gaoyichuan/Spectrometer_Tang/mechinal/slit-magnet-holder.sldprt

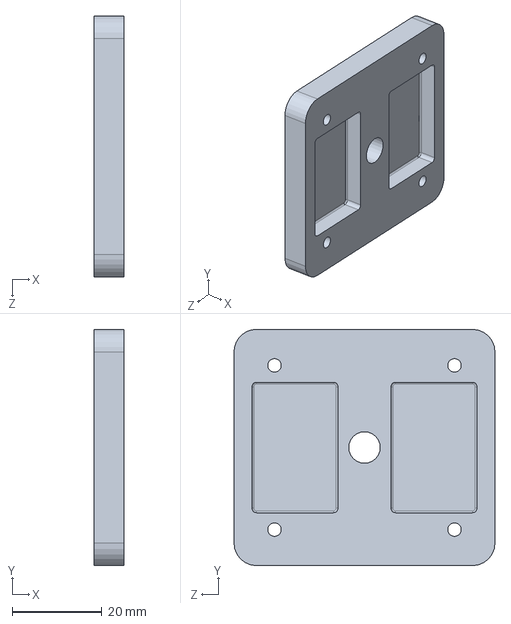
[picture p1: CAD file, 2019-06-28]
mechinal/slit-magnet-holder.sldprt
6.70 x 52.5 x 58.0 mm
