gaoyichuan/Spectrometer_Tang/mechinal/spectrometer-box.sldprt

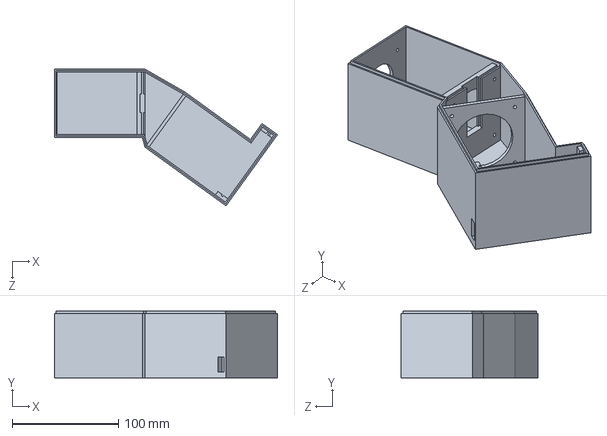
[picture p2: CAD file, 2019-06-28]
mechinal/spectrometer-box.sldprt
209.5 x 62.5 x 128.4 mm
