gaoyichuan/Spectrometer_Tang/mechinal/grating-holder.sldprt

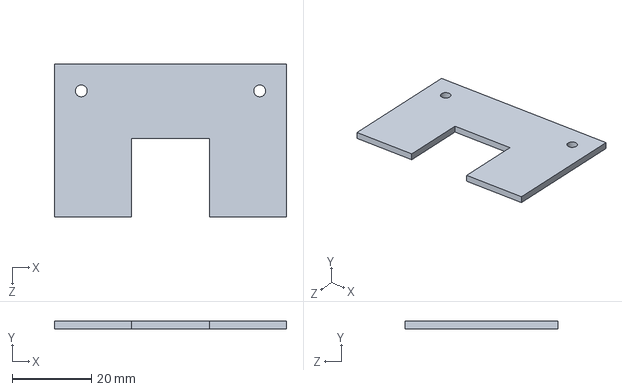
[picture p3: CAD file, 2019-06-28]
mechinal/grating-holder.sldprt
58.5 x 1.90 x 38.5 mm
