gaoyichuan/Spectrometer_Tang/mechinal/spectrometer-top.sldprt

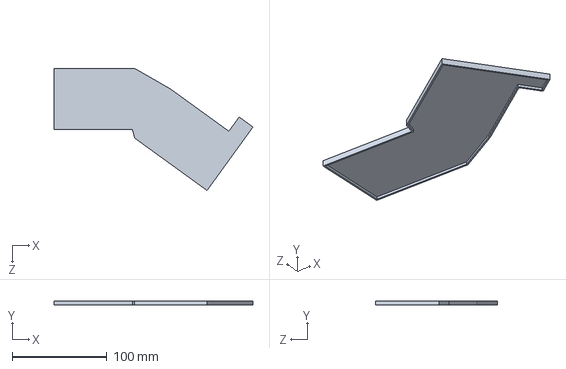
[picture p4: CAD file, 2019-06-28]
mechinal/spectrometer-top.sldprt
209.5 x 4.50 x 128.4 mm
