gaoyichuan/Spectrometer_Tang/(list of files, cad)

Other CAD files:
mechinal/slit-magnet-holder.stl
mechinal/spectrometer-box.stl
mechinal/spectrometer-top.stl
