gaoyichuan/Spectrometer_Tang/hardware/Spectrometer_Tang.pdf

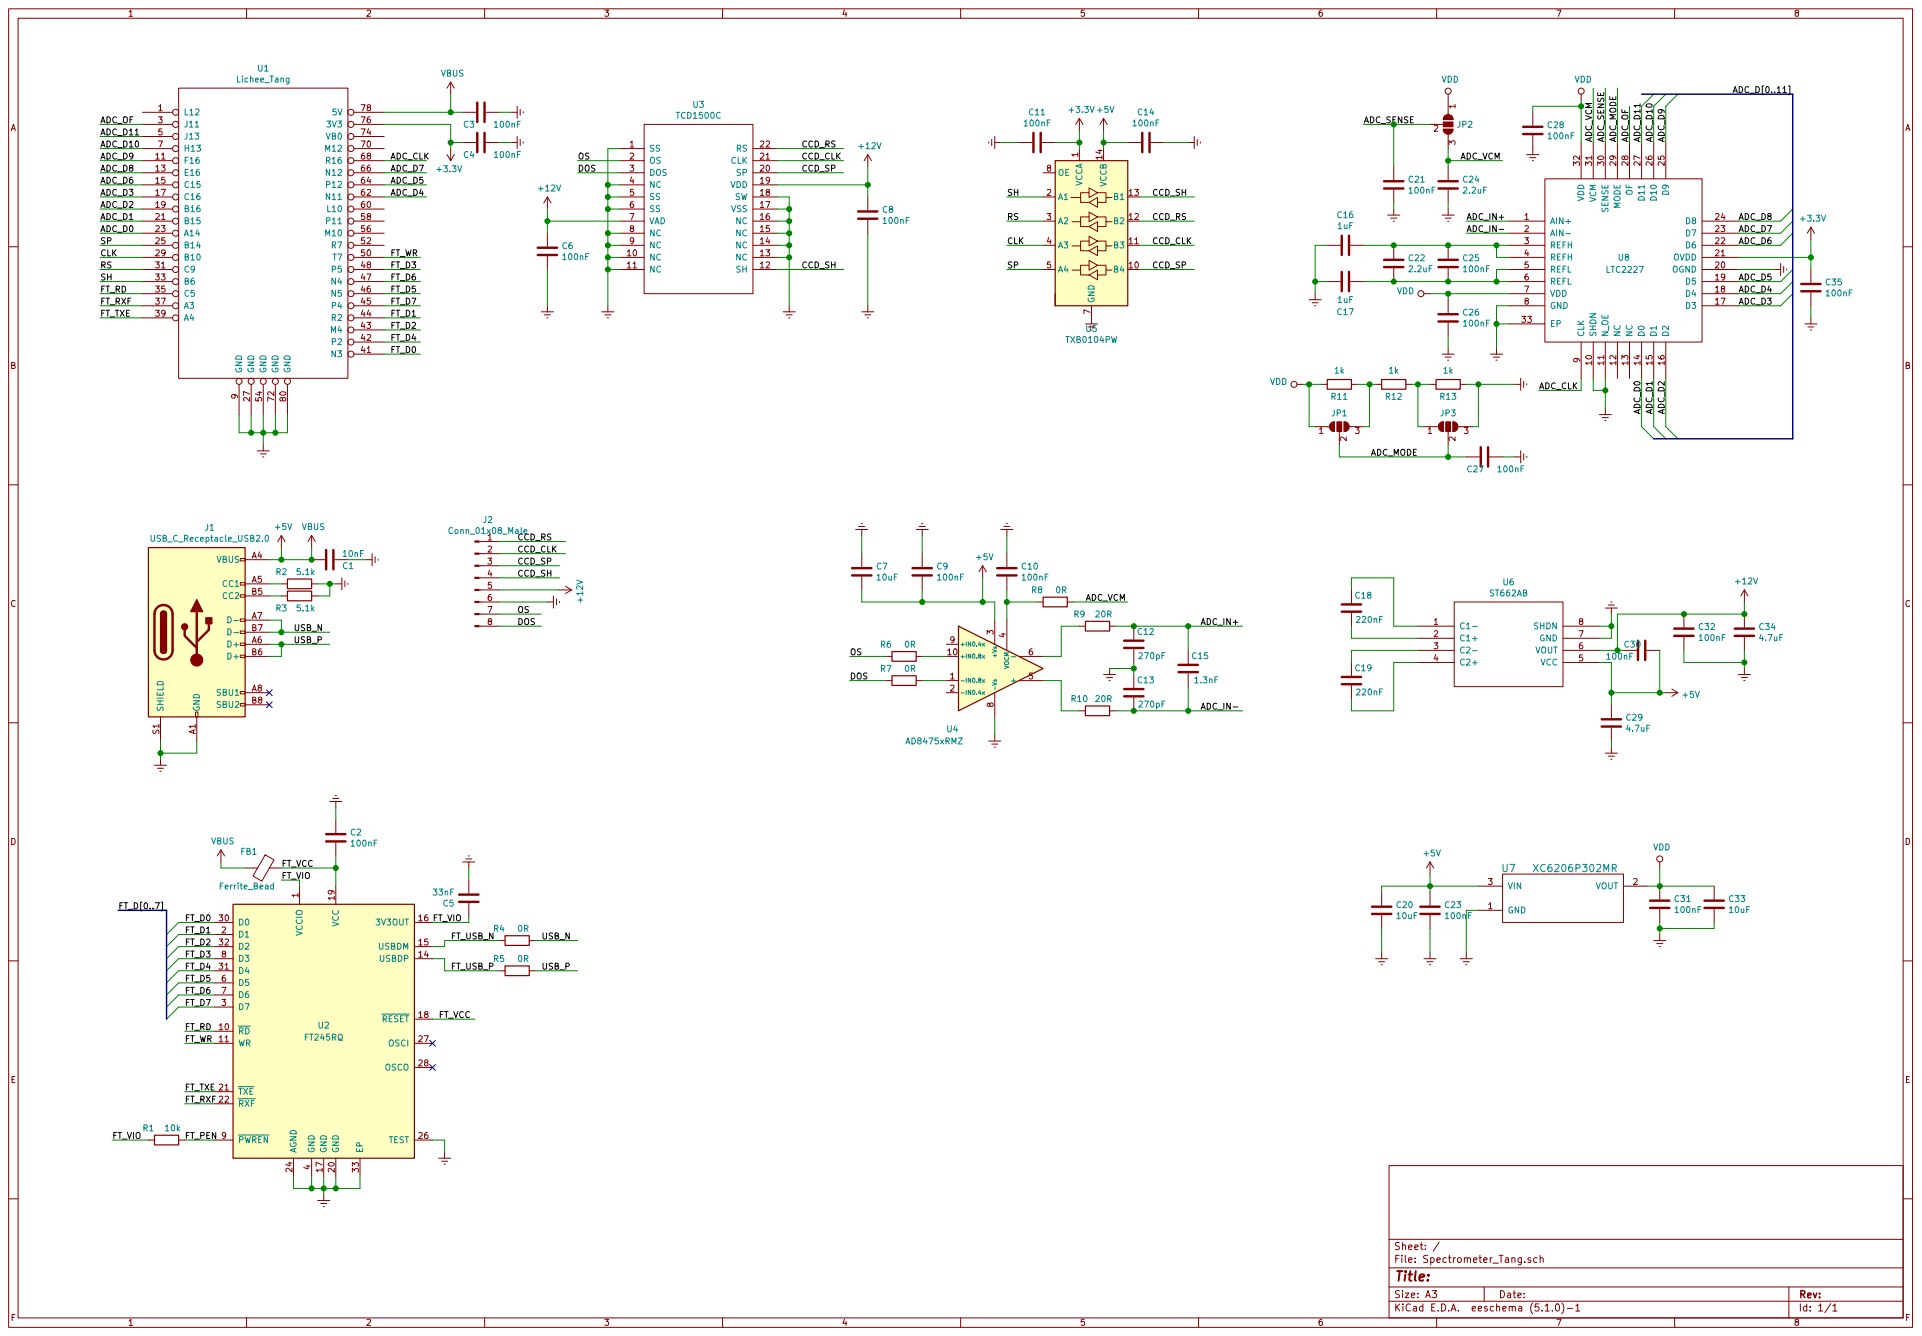
[picture p5: page 1]

1 RD 10 WR 11 USBDP 14 USBDM 15
