gaoyichuan/Spectrometer_Tang/hardware/Spectrometer_Tang.kicad_pcb

## KiCad design hardware/Spectrometer_Tang.kicad_pcb (2019-11-11)

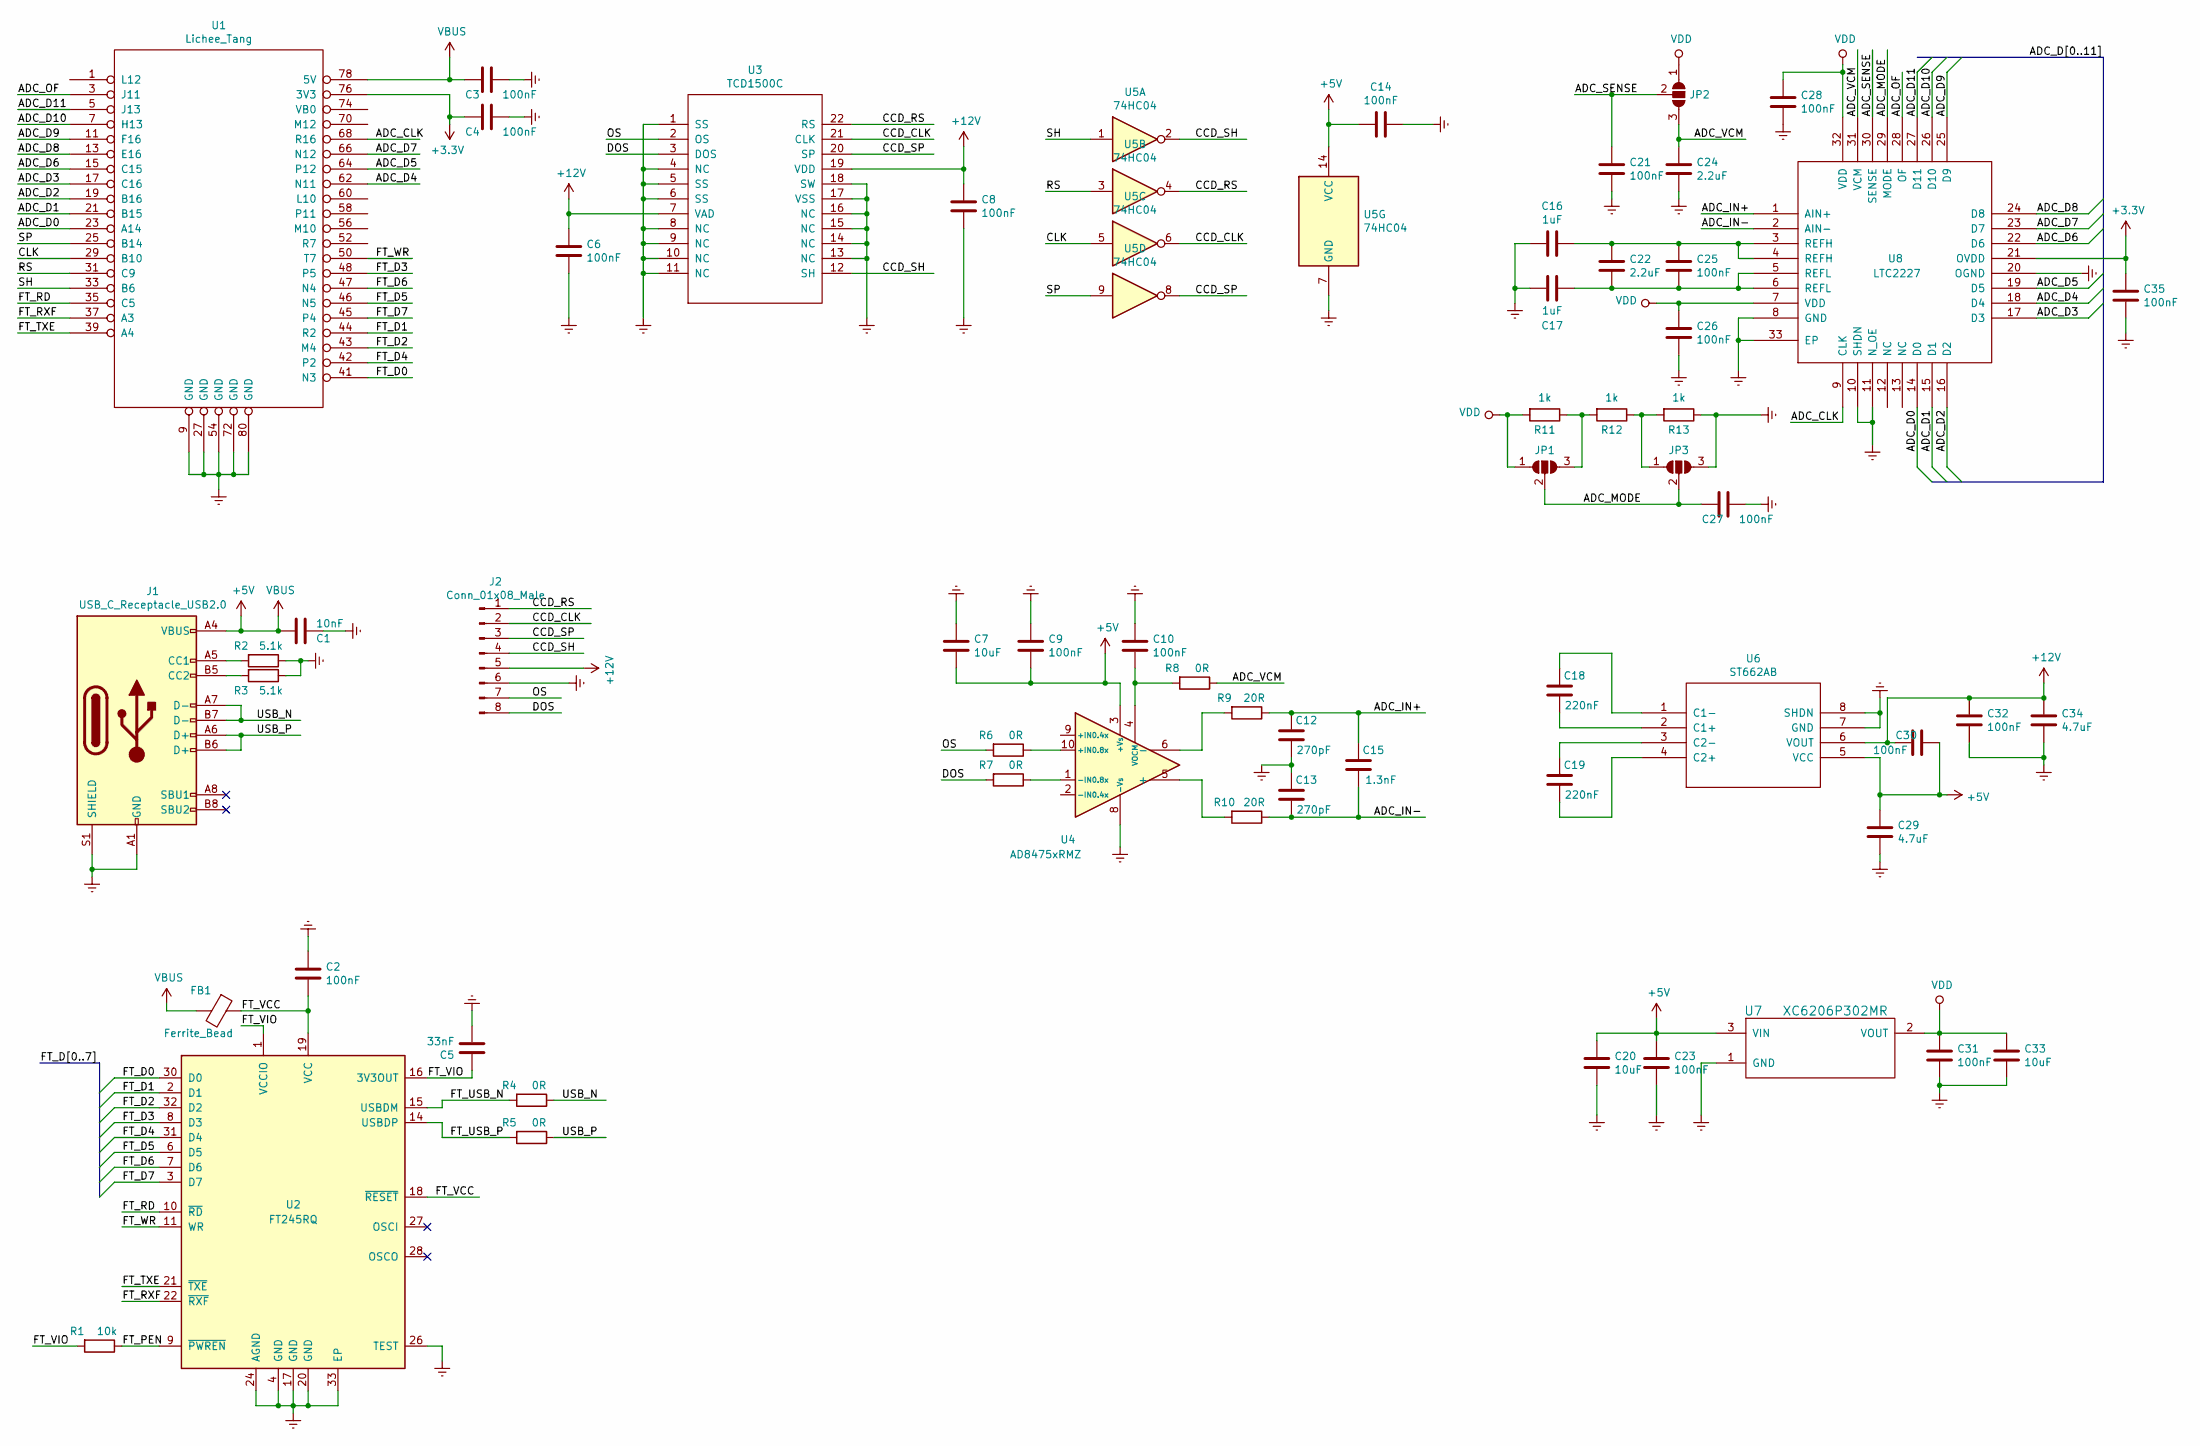
[picture p6: schematic Spectrometer_Tang.sch]

Parts:
C1: 10nF; C_0603_1608Metric_Pad1.05x0.95mm_HandSolder
C2, C3, C4, C6, C8, C9, C10, C14, C21, C23, C25, C26, C27, C28, C30, C31, C32, C35: 100nF; C_0603_1608Metric_Pad1.05x0.95mm_HandSolder
C5: 33nF; C_0603_1608Metric_Pad1.05x0.95mm_HandSolder
C7, C20, C33: 10uF; C_0603_1608Metric_Pad1.05x0.95mm_HandSolder
C12, C13: 270pF; C_0603_1608Metric_Pad1.05x0.95mm_HandSolder
C15: 1.3nF; C_0603_1608Metric_Pad1.05x0.95mm_HandSolder
C16, C17: 1uF; C_0603_1608Metric_Pad1.05x0.95mm_HandSolder
C18, C19: 220nF; C_0603_1608Metric_Pad1.05x0.95mm_HandSolder
C22, C24: 2.2uF; C_0603_1608Metric_Pad1.05x0.95mm_HandSolder
C29, C34: 4.7uF; C_0805_2012Metric
FB1: Ferrite_Bead; R_0603_1608Metric
J1: USB_C_Receptacle_USB2.0; USB_C_Receptacle_HRO_TYPE-C-31-M-12
J2: Conn_01x08_Male; PinHeader_1x08_P2.54mm_Vertical
JP1, JP2, JP3: SolderJumper_3_Open; SolderJumper-3_P1.3mm_Open_RoundedPad1.0x1.5mm
R1: 10k; R_0603_1608Metric_Pad1.05x0.95mm_HandSolder
R2, R3: 5.1k; R_0603_1608Metric_Pad1.05x0.95mm_HandSolder
R4, R5, R6, R7, R8: 0R; R_0603_1608Metric_Pad1.05x0.95mm_HandSolder
R9, R10: 20R; R_0603_1608Metric_Pad1.05x0.95mm_HandSolder
R11, R12, R13: 1k; R_0603_1608Metric_Pad1.05x0.95mm_HandSolder
U1: Lichee_Tang; Lichee-Tang-Module
U2: FT245RQ; QFN-32-1EP_5x5mm_P0.5mm_EP3.45x3.45mm_ThermalVias
U3: TCD1500C
U4: AD8475xRMZ; MSOP-10_3x3mm_P0.5mm
U5: 74HC04
U6: ST662AB; SO-8_3.9x4.9mm_P1.27mm
U7: XC6206P302MR; SOT-23
U8: LTC2227; QFN-32-1EP_5x5mm_P0.5mm_EP3.45x3.45mm_ThermalVias

Connections:
+3V3: C4.2, C35.1, U1.76 (3V3), U8.21 (OVDD)
+5V: C1.2, C3.2, C7.2, C9.2, C14.2, C20.1, C23.1, C29.1, C30.1, FB1.2, J1.A4 (VBUS), J1.A9 (VBUS), J1.B4 (VBUS), J1.B9 (VBUS), U1.78 (5V), U4.3 (+Vs), U5.14 (VCC), U6.5 (VCC), U7.3 (VIN)
+12V: C6.1, C8.1, C30.2, C32.1, C34.1, J2.5, U3.7 (VAD), U3.19 (VDD), U6.6 (VOUT)
/ADC_CLK: U1.68 (R16), U8.9 (CLK)
/ADC_D0: U1.23 (A14), U8.14 (D0)
/ADC_D1: U1.21 (B15), U8.15 (D1)
/ADC_D2: U1.19 (B16), U8.16 (D2)
/ADC_D3: U1.17 (C16), U8.17 (D3)
/ADC_D4: U1.62 (N11), U8.18 (D4)
/ADC_D5: U1.64 (P12), U8.19 (D5)
/ADC_D6: U1.15 (C15), U8.22 (D6)
/ADC_D7: U1.66 (N12), U8.23 (D7)
/ADC_D8: U1.13 (E16), U8.24 (D8)
/ADC_D9: U1.11 (F16), U8.25 (D9)
/ADC_D10: U1.7 (H13), U8.26 (D10)
/ADC_D11: U1.5 (J13), U8.27 (D11)
/ADC_IN+: C12.2, C15.2, R9.1, U8.1 (AIN+)
/ADC_IN-: C13.1, C15.1, R10.1, U8.2 (AIN-)
/ADC_MODE: C27.2, JP1.2 (C), JP3.2 (C), U8.29 (MODE)
/ADC_OF: U1.3 (J11), U8.28 (OF)
/ADC_SENSE: C21.1, JP2.2 (C), U8.30 (SENSE)
/ADC_VCM: C24.1, JP2.3 (B), R8.1, U8.31 (VCM)
/CCD_CLK: J2.2, U3.21 (CLK), U5.6
/CCD_RS: J2.1, U3.22 (RS), U5.4
/CCD_SH: J2.4, U3.12 (SH), U5.2
/CCD_SP: J2.3, U3.20 (SP), U5.8
/CLK: U1.29 (B10), U5.5
/DOS: J2.8, R7.2, U3.3 (DOS)
/FT_D0: U1.41 (N3), U2.30 (D0)
/FT_D1: U1.44 (R2), U2.2 (D1)
/FT_D2: U1.43 (M4), U2.32 (D2)
/FT_D3: U1.48 (P5), U2.8 (D3)
/FT_D4: U1.42 (P2), U2.31 (D4)
/FT_D5: U1.46 (N5), U2.6 (D5)
/FT_D6: U1.47 (N4), U2.7 (D6)
/FT_D7: U1.45 (P4), U2.3 (D7)
/FT_PEN: R1.1, U2.9 (~PWREN)
/FT_RD: U1.35 (C5), U2.10 (~RD)
/FT_RXF: U1.37 (A3), U2.22 (~RXF)
/FT_TXE: U1.39 (A4), U2.21 (~TXE)
/FT_USB_N: R4.2, U2.15 (USBDM)
/FT_USB_P: R5.2, U2.14 (USBDP)
/FT_VCC: C2.2, FB1.1, U2.18 (~RESET), U2.19 (VCC)
/FT_VIO: C5.1, R1.2, U2.1 (VCCIO), U2.16 (3V3OUT)
/FT_WR: U1.50 (T7), U2.11 (WR)
/OS: J2.7, R6.2, U3.2 (OS)
/RS: U1.31 (C9), U5.3
/SH: U1.33 (B6), U5.1
/SP: U1.25 (B14), U5.9
/USB_N: J1.A7 (D-), J1.B7 (D-), R4.1
/USB_P: J1.A6 (D+), J1.B6 (D+), R5.1
Earth: C1.1, C2.1, C3.1, C4.1, C5.2, C6.2, C7.1, C8.2, C9.1, C10.1, C12.1, C13.2, C14.1, C16.2, C17.2, C20.2, C21.2, C23.2, C24.2, C26.2, C27.1, C28.2, C29.2, C31.2, C32.2, C33.2, C34.2, C35.2, J1.A1 (GND), J1.A12 (GND), J1.B1 (GND), J1.B12 (GND), J1.S1 (SHIELD), J2.6, JP3.3 (B), R2.1, R3.1, R13.1, U1.9 (GND), U1.27 (GND), U1.54 (GND), U1.72 (GND), U1.80 (GND), U2.4 (GND), U2.17 (GND), U2.20 (GND), U2.24 (AGND), U2.26 (TEST), U2.33 (EP), U3.1 (SS), U3.4 (NC), U3.5 (SS), U3.6 (SS), U3.8 (NC), U3.9 (NC), U3.10 (NC), U3.11 (NC), U3.13 (NC), U3.14 (NC), U3.15 (NC), U3.16 (NC), U3.17 (VSS), U3.18 (SW), U4.8 (-Vs), U5.7 (GND), U6.7 (GND), U6.8 (SHDN), U7.1 (GND), U8.8 (GND), U8.10 (SHDN), U8.11 (N_OE), U8.20 (OGND), U8.33 (EP)
unnamed: C10.2, R8.2, U4.4 (VOCM)
unnamed: C16.1, C22.1, C25.1, U8.3 (REFH), U8.4 (REFH)
unnamed: C17.1, C22.2, C25.2, U8.5 (REFL), U8.6 (REFL)
unnamed: C18.1, U6.2 (C1+)
unnamed: C18.2, U6.1 (C1-)
unnamed: C19.1, U6.4 (C2+)
unnamed: C19.2, U6.3 (C2-)
unnamed: J1.A5 (CC1), R2.2
unnamed: J1.B5 (CC2), R3.2
unnamed: JP1.3 (B), R11.1, R12.2
unnamed: JP3.1 (A), R12.1, R13.2
unnamed: R6.1, U4.10 (+IN0.8x)
unnamed: R7.1, U4.1 (-IN0.8x)
unnamed: R9.2, U4.6 (-)
unnamed: R10.2, U4.5 (+)
VDD: C26.1, C28.1, C31.1, C33.1, JP1.1 (A), JP2.1 (A), R11.2, U7.2 (VOUT), U8.7 (VDD), U8.32 (VDD)

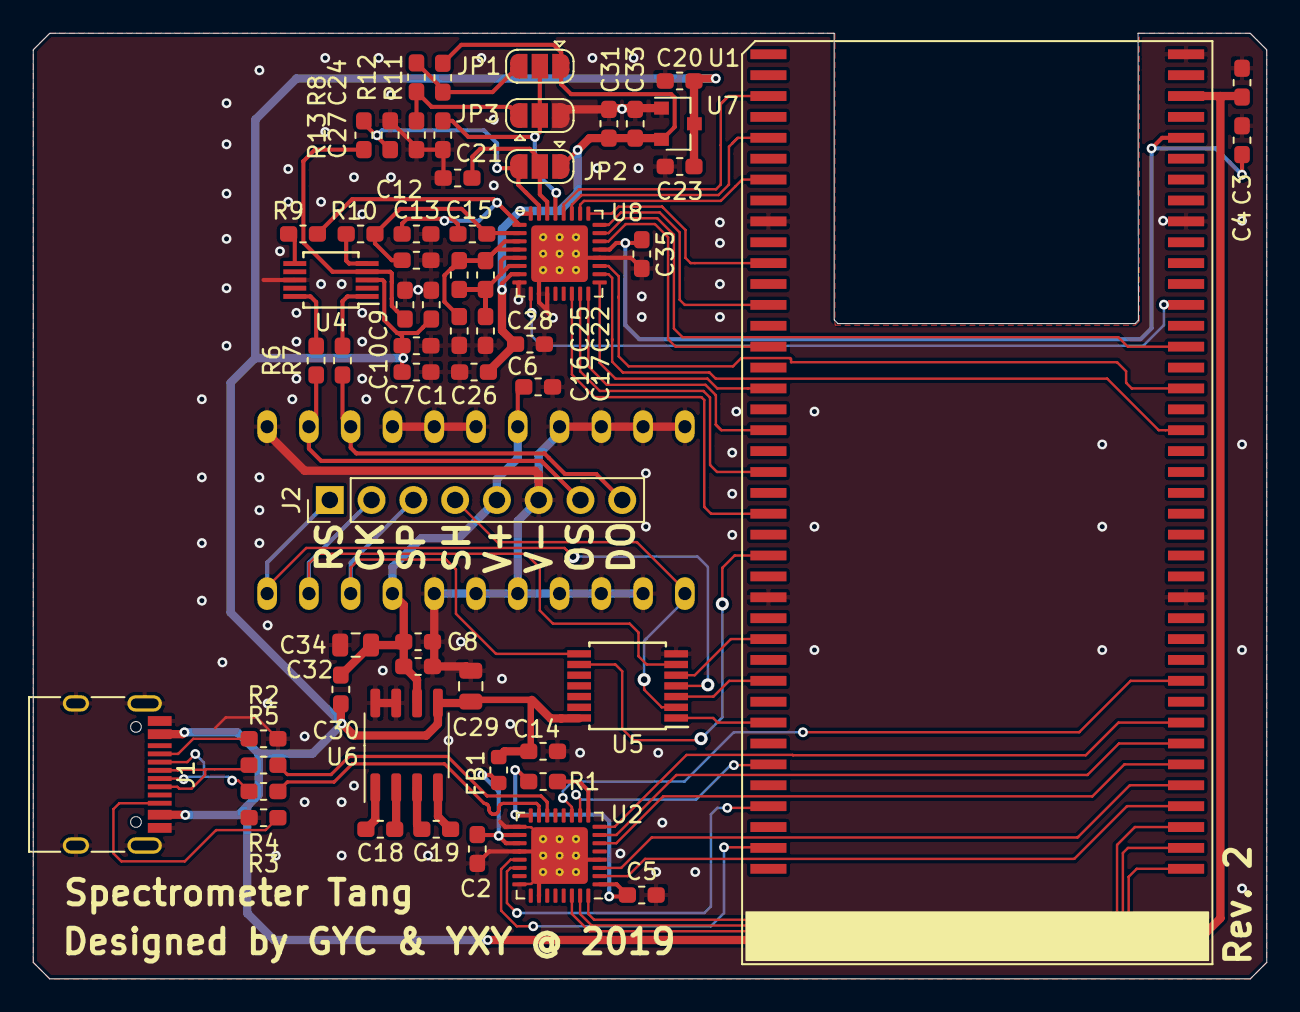
[picture p7: board Spectrometer_Tang.kicad_pcb from above]

Board: 2 copper layers, 75.0 x 57.5 mm, 61 parts (1 on the bottom side), 68 nets.
