gaoyichuan/Spectrometer_Tang/firmware/al_ip/ip_pll_sim.v

// Verilog netlist created by TD v4.4.433
// Wed Jun 26 20:08:53 2019

`timescale 1ns / 1ps
module ip_pll  // al_ip/ip_pll.v(22)
  (
  refclk,
  reset,
  clk0_out
  );

  input refclk;  // al_ip/ip_pll.v(26)
  input reset;  // al_ip/ip_pll.v(27)
  output clk0_out;  // al_ip/ip_pll.v(28)

  wire clk0_buf;  // al_ip/ip_pll.v(30)

  EG_PHY_GCLK bufg_feedback (
    .clki(clk0_buf),
    .clko(clk0_out));  // al_ip/ip_pll.v(32)
  EG_PHY_CONFIG #(
    .DONE_PERSISTN("ENABLE"),
    .INIT_PERSISTN("ENABLE"),
    .JTAG_PERSISTN("DISABLE"),
    .PROGRAMN_PERSISTN("DISABLE"))
    config_inst ();
  EG_PHY_PLL #(
    .CLKC0_CPHASE(99),
    .CLKC0_DIV(100),
    .CLKC0_DIV2_ENABLE("DISABLE"),
    .CLKC0_ENABLE("ENABLE"),
    .CLKC0_FPHASE(0),
    .CLKC1_CPHASE(1),
    .CLKC1_DIV(1),
    .CLKC1_DIV2_ENABLE("DISABLE"),
    .CLKC1_ENABLE("DISABLE"),
    .CLKC1_FPHASE(0),
    .CLKC2_CPHASE(1),
    .CLKC2_DIV(1),
    .CLKC2_DIV2_ENABLE("DISABLE"),
    .CLKC2_ENABLE("DISABLE"),
    .CLKC2_FPHASE(0),
    .CLKC3_CPHASE(1),
    .CLKC3_DIV(1),
    .CLKC3_DIV2_ENABLE("DISABLE"),
    .CLKC3_ENABLE("DISABLE"),
    .CLKC3_FPHASE(0),
    .CLKC4_CPHASE(1),
    .CLKC4_DIV(1),
    .CLKC4_DIV2_ENABLE("DISABLE"),
    .CLKC4_ENABLE("DISABLE"),
    .CLKC4_FPHASE(0),
    .DERIVE_PLL_CLOCKS("ENABLE"),
    .DPHASE_SOURCE("DISABLE"),
    .DYNCFG("DISABLE"),
    .FBCLK_DIV(5),
    .FEEDBK_MODE("NORMAL"),
    .FEEDBK_PATH("CLKC0_EXT"),
    .FIN("24.000"),
    .FREQ_LOCK_ACCURACY(2),
    .GEN_BASIC_CLOCK("ENABLE"),
    .GMC_GAIN(6),
    .GMC_TEST(14),
    .ICP_CURRENT(3),
    .IF_ESCLKSTSW("DISABLE"),
    .INTFB_WAKE("DISABLE"),
    .KVCO(6),
    .LPF_CAPACITOR(3),
    .LPF_RESISTOR(2),
    .NORESET("DISABLE"),
    .ODIV_MUXC0("DIV"),
    .ODIV_MUXC1("DIV"),
    .ODIV_MUXC2("DIV"),
    .ODIV_MUXC3("DIV"),
    .ODIV_MUXC4("DIV"),
    .PLLC2RST_ENA("DISABLE"),
    .PLLC34RST_ENA("DISABLE"),
    .PLLMRST_ENA("DISABLE"),
    .PLLRST_ENA("ENABLE"),
    .PLL_LOCK_MODE(0),
    .PREDIV_MUXC0("VCO"),
    .PREDIV_MUXC1("VCO"),
    .PREDIV_MUXC2("VCO"),
    .PREDIV_MUXC3("VCO"),
    .PREDIV_MUXC4("VCO"),
    .REFCLK_DIV(12),
    .REFCLK_SEL("INTERNAL"),
    .STDBY_ENABLE("DISABLE"),
    .STDBY_VCO_ENA("DISABLE"),
    .SYNC_ENABLE("DISABLE"),
    .VCO_NORESET("DISABLE"))
    pll_inst (
    .daddr(6'b000000),
    .dclk(1'b0),
    .dcs(1'b0),
    .di(8'b00000000),
    .dwe(1'b0),
    .fbclk(clk0_out),
    .psclk(1'b0),
    .psclksel(3'b000),
    .psdown(1'b0),
    .psstep(1'b0),
    .refclk(refclk),
    .reset(reset),
    .stdby(1'b0),
    .clkc({open_n47,open_n48,open_n49,open_n50,clk0_buf}));  // al_ip/ip_pll.v(55)

endmodule 
