gaoyichuan/Spectrometer_Tang/(commit log)

2019-05-02 working ccd driver
2019-05-02 change adc filename to ltc2227
2019-05-02 update io constraint for ADC pins
2019-05-22 Rewrite CCD driver
    temp version
    part code
    temp commit
    work version
    update gitignore
2019-06-28 Add mechinal files
    [grating-holder.sldprt, slit-magnet-holder.sldprt, slit-magnet-holder.stl, spectrometer-box.sldprt, spectrometer-box.stl, spectrometer-top.sldprt, spectrometer-top.stl]
2019-11-11 Fix level converter & usb port location
    [Spectrometer_Tang.kicad_pcb, Spectrometer_Tang.sch]
